acrerd/magnetometer-board/hardware/manufacturing/v1/populated-board-bottom.png

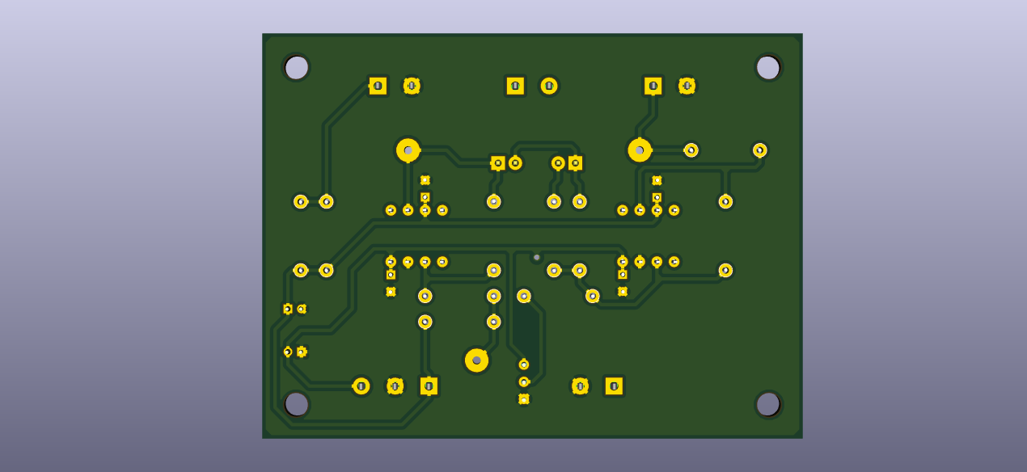
hardware/manufacturing/v1/populated-board-bottom.png
