acrerd/magnetometer-board/hardware/manufacturing/v1/populated-board-top.png

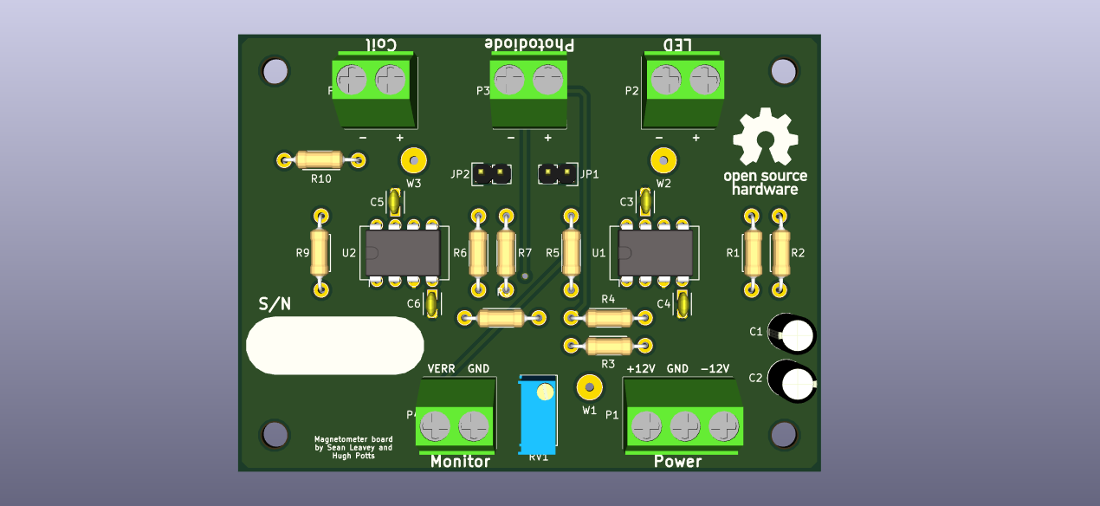
hardware/manufacturing/v1/populated-board-top.png
