acrerd/magnetometer-board/README.md

# Magnetometer schematic and printed circuit board
Printed circuit board design for the magnetometer honours project
