acrerd/magnetometer-board/hardware/magnetometer.kicad_pcb

## KiCad design hardware/magnetometer.kicad_pcb (2017-10-23)

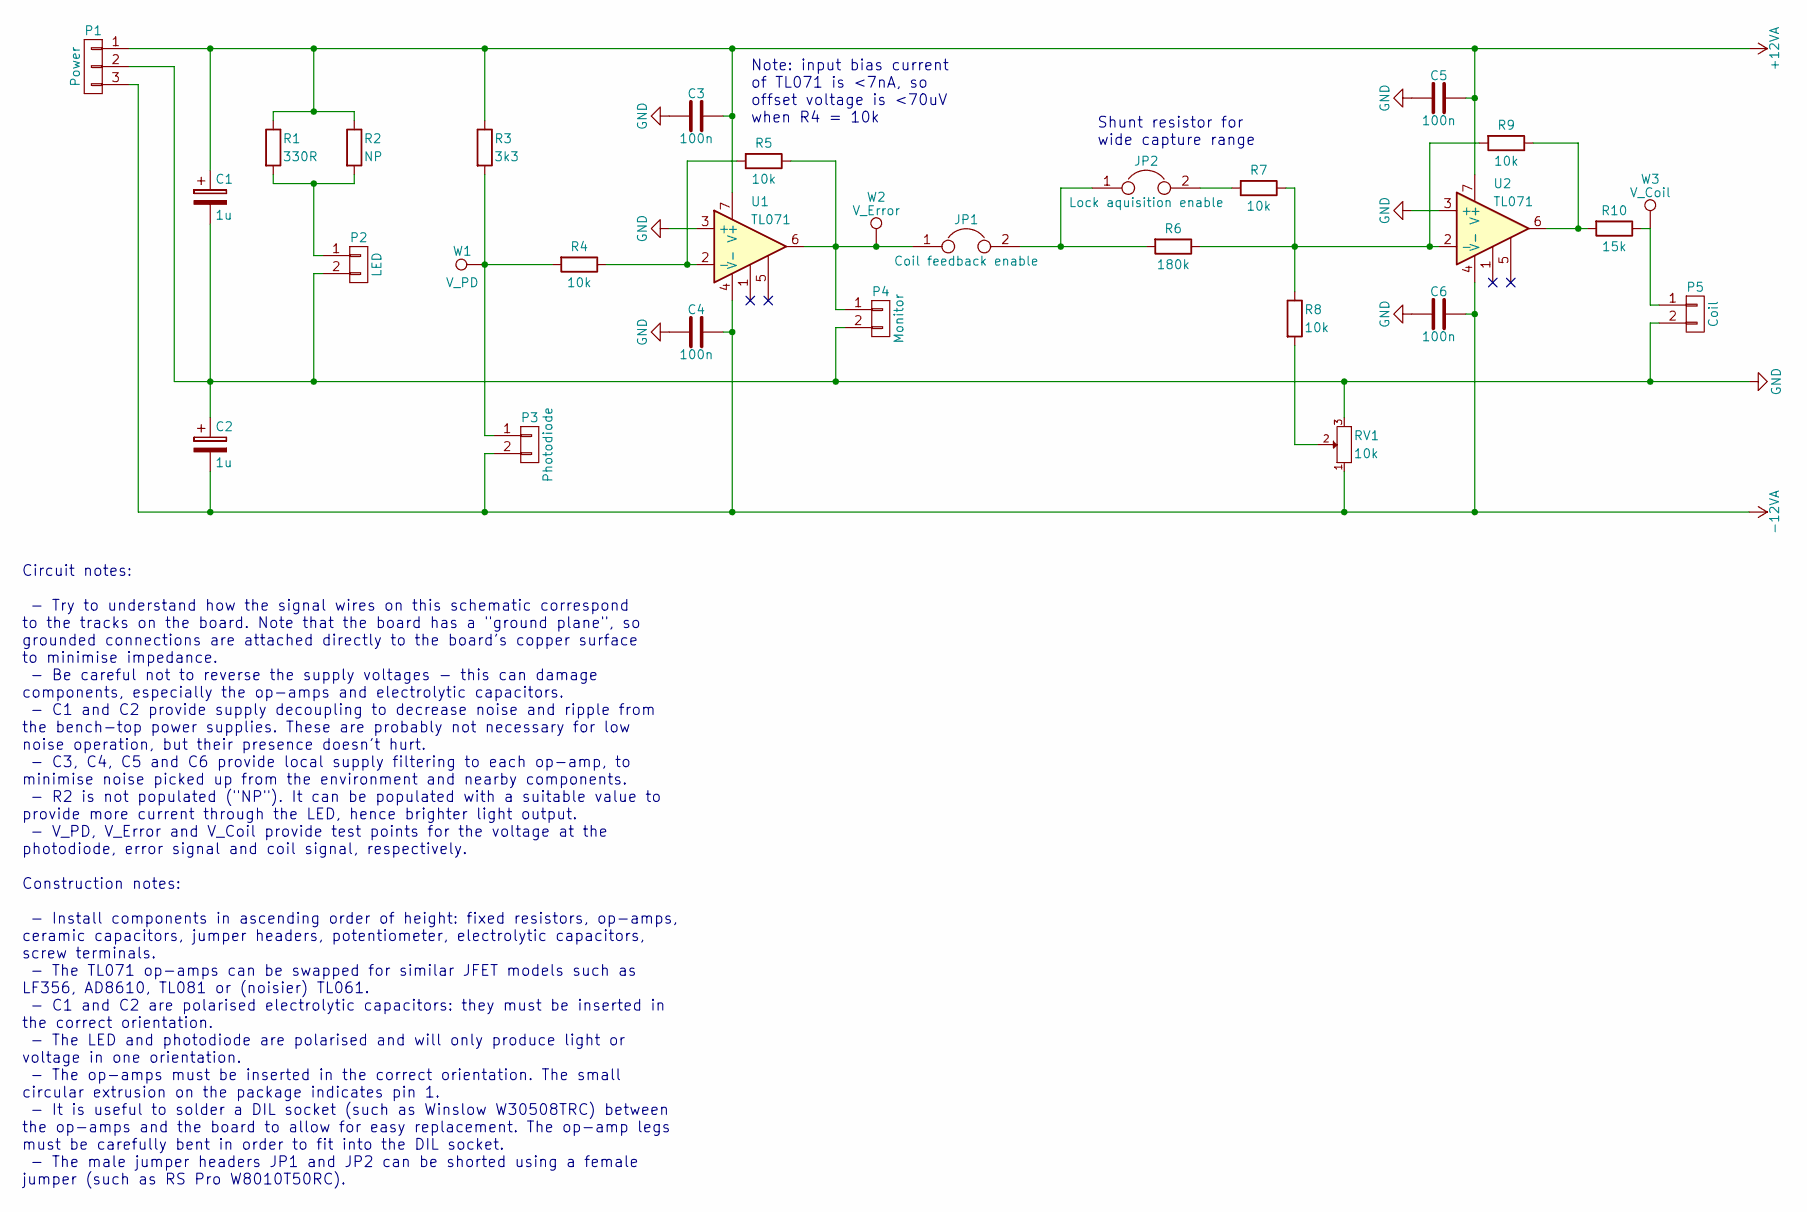
[picture p4: schematic magnetometer.sch, Magnetometer board]

Parts:
C1, C2: 1u; C_Radial_D5_L11_P2; MPN1 711-1407
C3, C4, C5, C6: 100n; C_Disc_D3_P2.5; MPN1 SR205E104MARTR
JP1: Coil feedback enable; Pin_Header_Straight_1x02; MPN1 W81102T3825RC
JP2: Lock aquisition enable; Pin_Header_Straight_1x02; MPN1 W81102T3825RC
P1: Power; TerminalBlock_Pheonix_MKDS1.5-3pol; MPN1 1751251
P2: LED; TerminalBlock_Pheonix_MKDS1.5-2pol; MPN1 1751248
P3: Photodiode; TerminalBlock_Pheonix_MKDS1.5-2pol; MPN1 1751248
P4: Monitor; TerminalBlock_Pheonix_MKDS1.5-2pol; MPN1 1751248
P5: Coil; TerminalBlock_Pheonix_MKDS1.5-2pol; MPN1 1751248
R1: 330R; Resistor_Horizontal_RM10mm; MPN1 707-7622
R2: NP; Resistor_Horizontal_RM10mm
R3: 3k3; Resistor_Horizontal_RM10mm; MPN1 707-7701
R4, R5, R7, R8, R9: 10k; Resistor_Horizontal_RM10mm; MPN1 707-7745
R6: 180k; Resistor_Horizontal_RM10mm; MPN1 707-7846
R10: 15k; Resistor_Horizontal_RM10mm; MPN1 707-7760
RV1: 10k; Potentiometer_Bourns_3296W_3-8Zoll_Inline_ScrewUp; MPN1 3296W-1-103LF
U1, U2: TL071; DIP-8_W7.62mm; MPN1 TL071ACP
W1: V_PD; SolderWirePad_single_1-2mmDrill
W2: V_Error; SolderWirePad_single_1-2mmDrill
W3: V_Coil; SolderWirePad_single_1-2mmDrill

Connections:
+12VA: C1.1, C3.1, C5.1, P1.1, R1.1, R2.1, R3.1, U1.7 (V+), U2.7 (V+)
-12VA: C2.2, C4.1, C6.1, P1.3, P3.2, RV1.1, U1.4 (V-), U2.4 (V-)
GND: C1.2, C2.1, C3.2, C4.2, C5.2, C6.2, P1.2, P2.2, P4.2, P5.2, RV1.3, U1.3 (+), U2.3 (+)
unnamed: JP1.1, P4.1, R5.1, U1.6, W2.1
unnamed: JP1.2, JP2.1, R6.2
unnamed: JP2.2, R7.2
unnamed: P2.1, R1.2, R2.2
unnamed: P3.1, R3.2, R4.2, W1.1
unnamed: P5.1, R10.1, W3.1
unnamed: R4.1, R5.2, U1.2 (-)
unnamed: R6.1, R7.1, R8.1, R9.2, U2.2 (-)
unnamed: R8.2, RV1.2
unnamed: R9.1, R10.2, U2.6

Notes on the sheet:
Note: input bias current of TL071 is <7nA, so offset voltage is <70uV when R4 = 10k
Shunt resistor for wide capture range
Circuit notes: - Try to understand how the signal wires on this schematic correspond to the tracks on the board. Note that the board has a "ground plane", so grounded connections are attached directly to the board's copper surface to minimise impedance. - Be careful not to reverse the supply voltag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

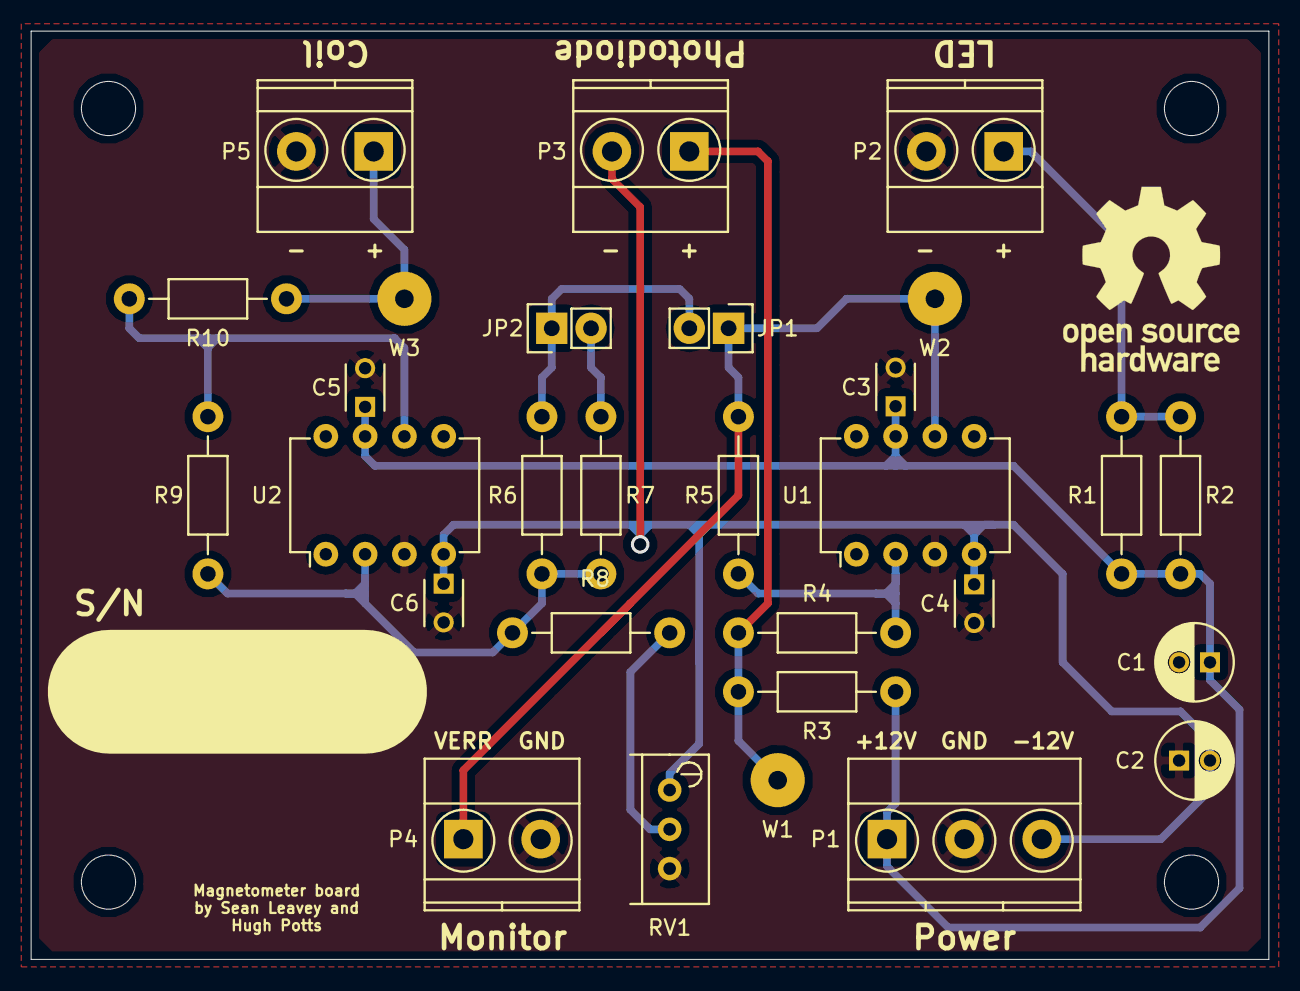
[picture p5: board magnetometer.kicad_pcb from above]

Board: 2 copper layers, 80.0 x 60.0 mm, 30 parts (0 on the bottom side), 13 nets.

Other parts of the board:
Ref**: Val**; 80mmx60mm_holes
