acrerd/magnetometer-board/(commit log)

2017-10-13 Draft schematic
    [magnetometer.kicad_pcb, magnetometer.sch]
2017-10-21 Board design
    [magnetometer.kicad_pcb]
2017-10-23 Gerber files for version 1
    [magnetometer-B.Cu.gbr, magnetometer-B.Mask.gbr, magnetometer-B.SilkS.gbr, magnetometer-Edge.Cuts.gbr, magnetometer-F.Cu.gbr, magnetometer-F.Mask.gbr, magnetometer-F.SilkS.gbr, magnetometer-NPTH.drl]
2017-10-23 Update page properties
    [magnetometer.kicad_pcb, magnetometer.sch]
2017-10-23 Bill of materials
2017-10-23 Board pictures for assembly
